Jahjahhhh/projet5/table-2/kicad_libraries/My_Libraries/P0915N-FC15AR50K.stp

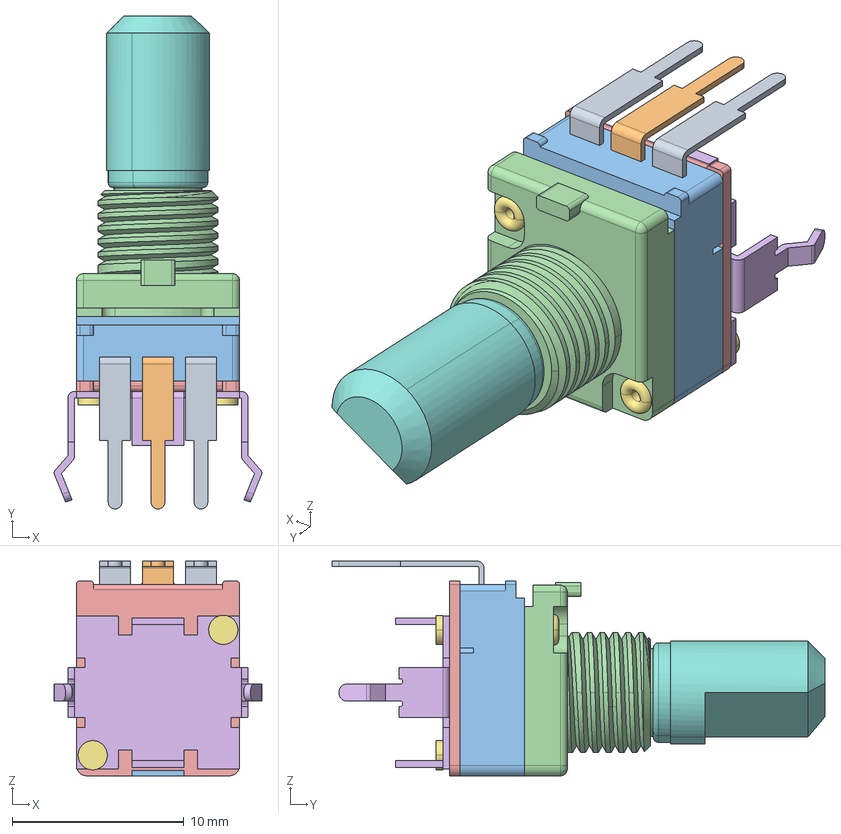
[picture p1: CAD file, 2024-10-07]
table-2/kicad_libraries/My_Libraries/P0915N-FC15AR50K.stp
12.1 x 28.7 x 12.5 mm
